KayembaLuwaga/Automated-Multipurpose-Distiller/Project_Pics/multipurpose_distiller_assemblyf.png

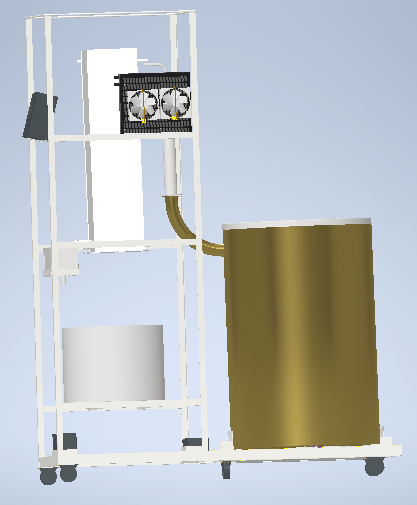
Project_Pics/multipurpose_distiller_assemblyf.png
