KayembaLuwaga/Automated-Multipurpose-Distiller/Project_Pics/multipurpose_distiller_assembly.png

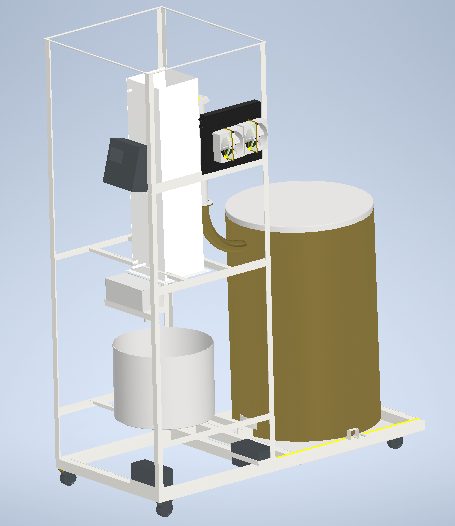
Project_Pics/multipurpose_distiller_assembly.png
