KayembaLuwaga/Automated-Multipurpose-Distiller/README.md

# Automated-Multipurpose-Distiller
Technical design, modeling &amp; optimization, and implementation of a Automated Multipurpose Distiller
