KayembaLuwaga/Automated-Multipurpose-Distiller/MATLAB_hw_programs/variables_attribution.docx

Variables Attribution

Machine Processes
Process | Actuator | Variable
Convection System | Radiator Fan | Atmospheric_Temp
| | Radiator_Temp
Cooling System | Coolant Pump | Referrential_Distillate_Temp
| | Distillate_Temp
| | Condenser_Temp
Distillate Draining System | Solenoid Valve | Distillate_Level
| | Referrential_Distillate_Level
Heater System | AC Heater Element | Still_Temp
| | Referrential_Still_Temp
| | Machine_Run_State
Functions
Function | Variable | Variable’s Values
System Monitor Function | Machine_Run_State | “Standby”, “Running” : (0, 1)
