KayembaLuwaga/Automated-Multipurpose-Distiller/MATLAB_hw_programs/twerk.jpg

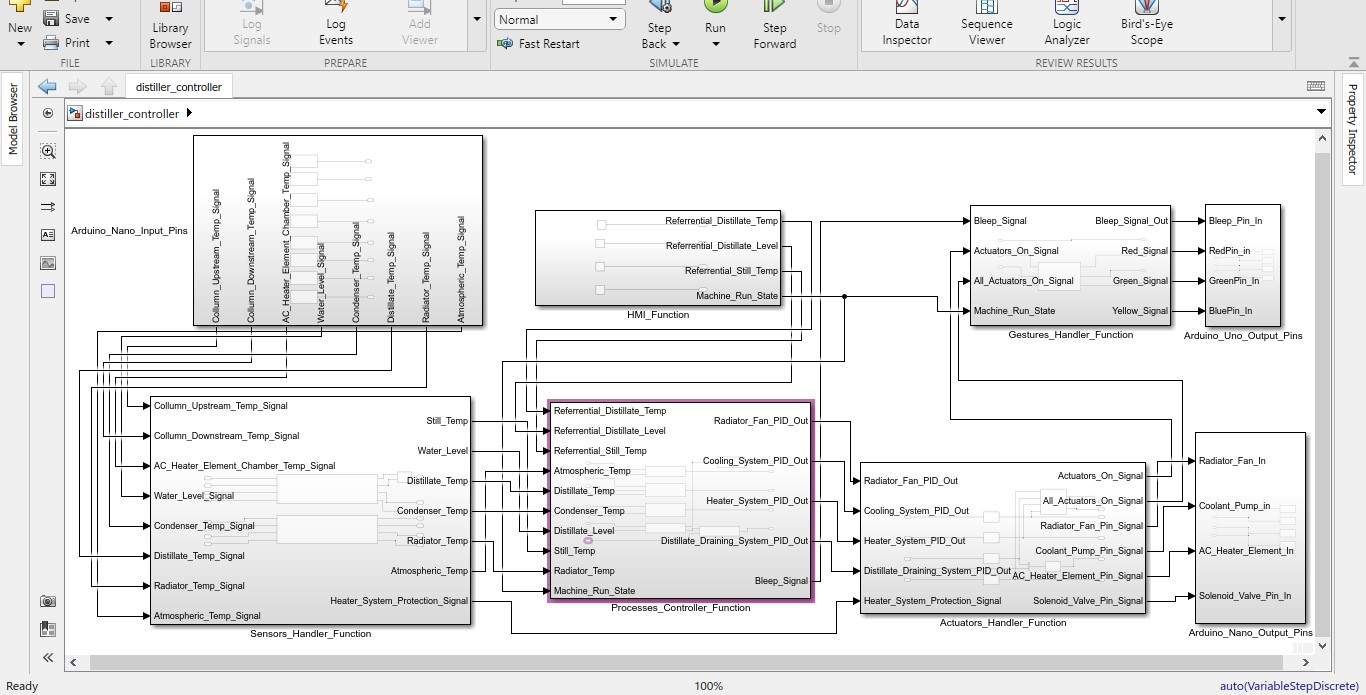
MATLAB_hw_programs/twerk.jpg
