KayembaLuwaga/Automated-Multipurpose-Distiller/Project_Pics/actuators_relay_switch.jpg

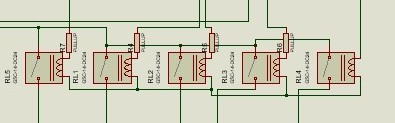
Project_Pics/actuators_relay_switch.jpg
