KayembaLuwaga/Automated-Multipurpose-Distiller/Project_Pics/actutors_hnd_func.jpg

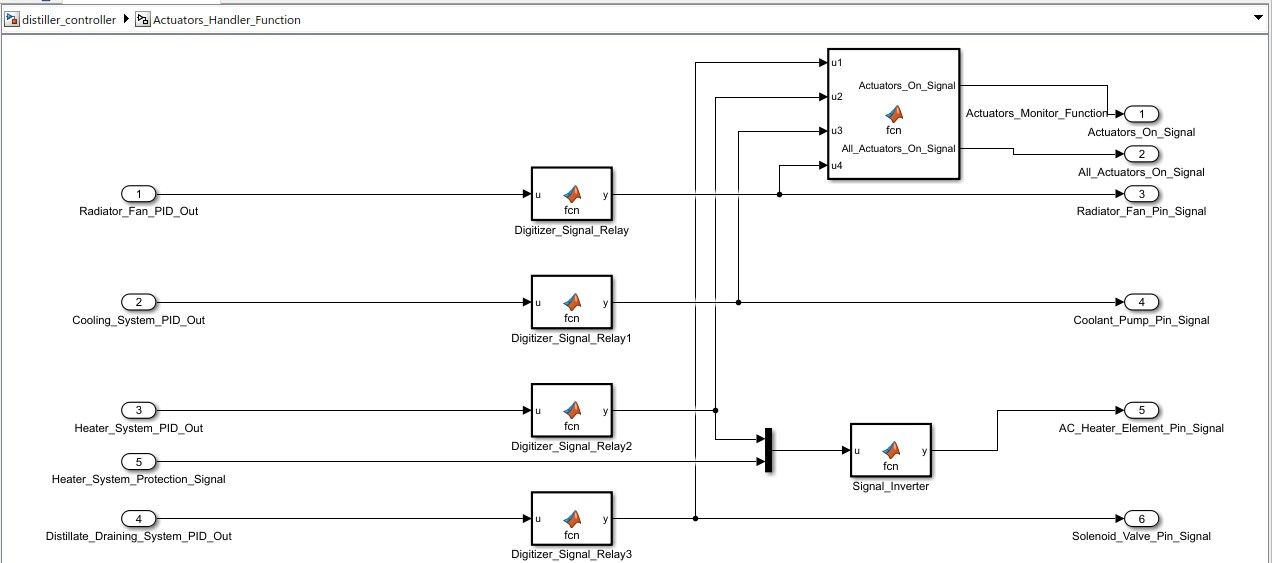
Project_Pics/actutors_hnd_func.jpg
