KayembaLuwaga/Automated-Multipurpose-Distiller/Project_Pics/bode_distillate.jpg

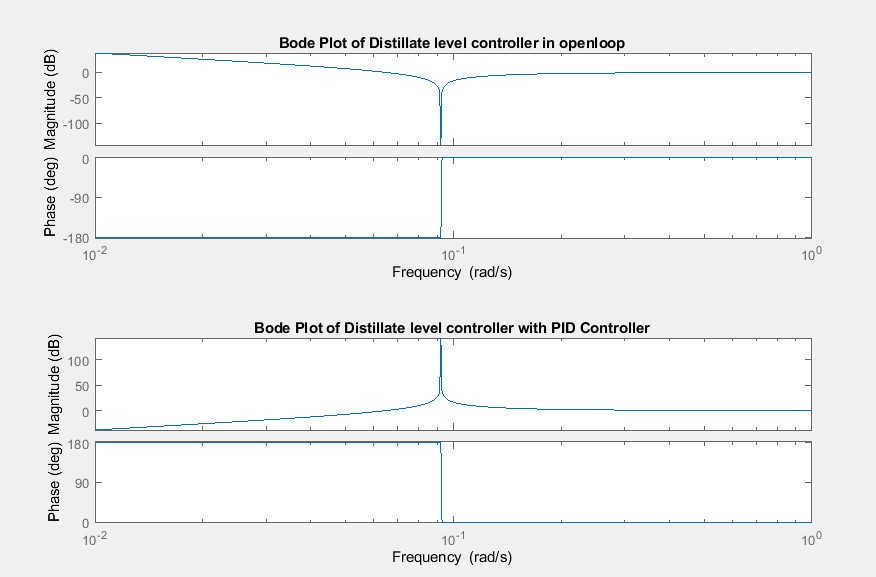
Project_Pics/bode_distillate.jpg
