KayembaLuwaga/Automated-Multipurpose-Distiller/Project_Pics/Copy of disitlate.jpg

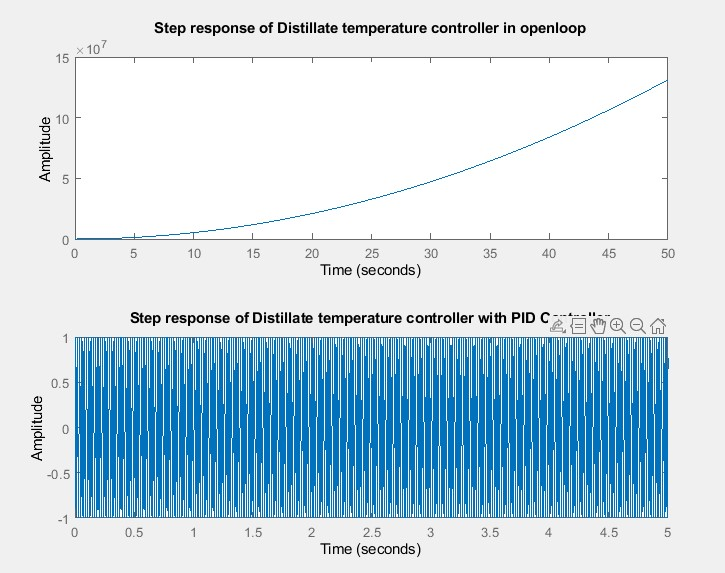
Project_Pics/Copy of disitlate.jpg
