KayembaLuwaga/Automated-Multipurpose-Distiller/Project_Pics/frame_displacement.JPG

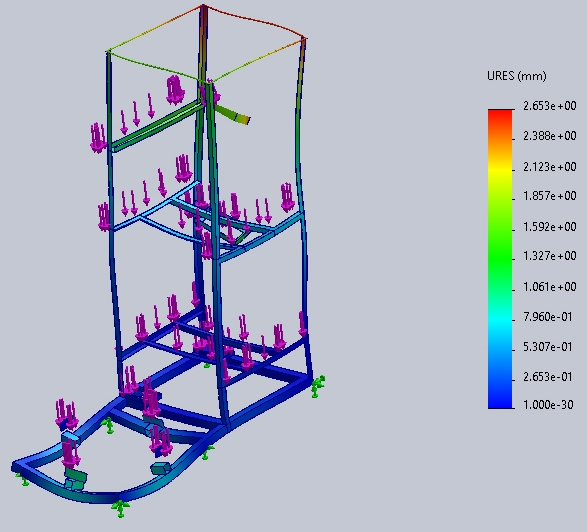
Project_Pics/frame_displacement.JPG
