KayembaLuwaga/Automated-Multipurpose-Distiller/Project_Pics/frame_von_Misses_stress.JPG

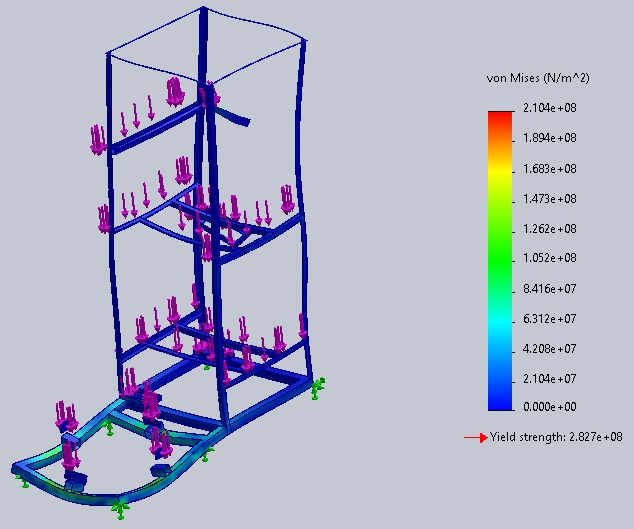
Project_Pics/frame_von_Misses_stress.JPG
