KayembaLuwaga/Automated-Multipurpose-Distiller/Project_Pics/gestures+func.jpg

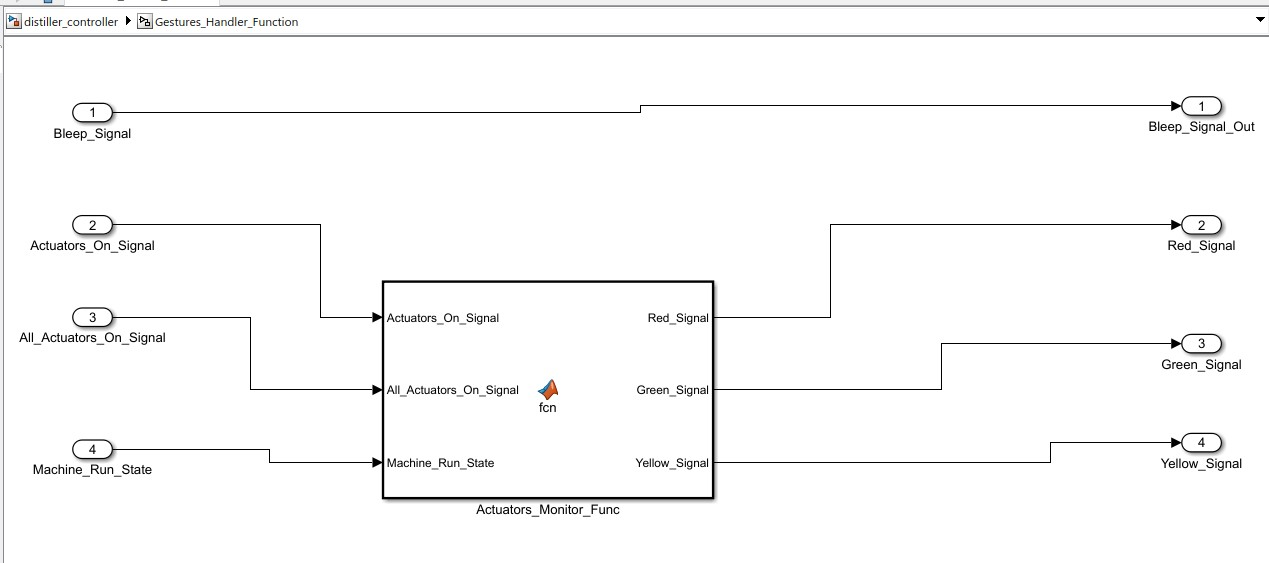
Project_Pics/gestures+func.jpg
