KayembaLuwaga/Automated-Multipurpose-Distiller/Project_Pics/hdw_ctrl_circuit.jpg

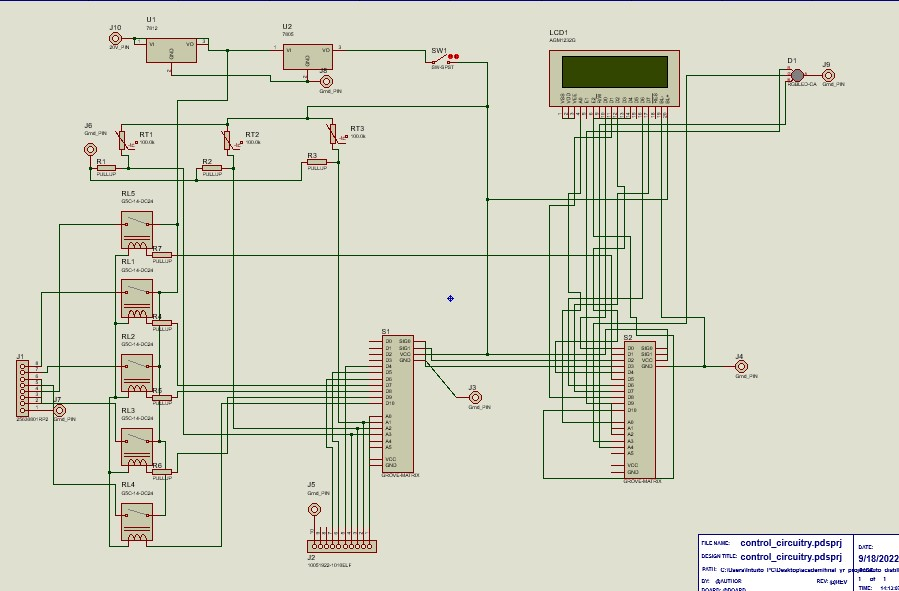
Project_Pics/hdw_ctrl_circuit.jpg
