KayembaLuwaga/Automated-Multipurpose-Distiller/Project_Pics/heat conv.jpg

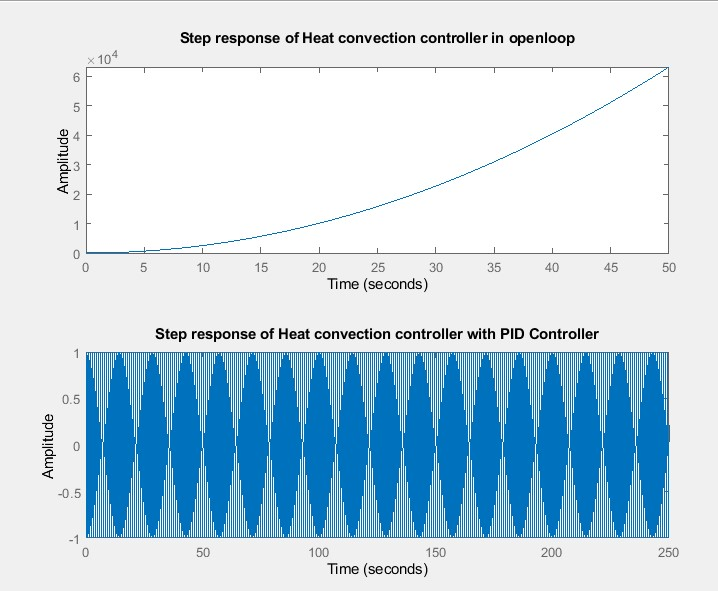
Project_Pics/heat conv.jpg
