KayembaLuwaga/Automated-Multipurpose-Distiller/Project_Pics/HMI_Function.jpg

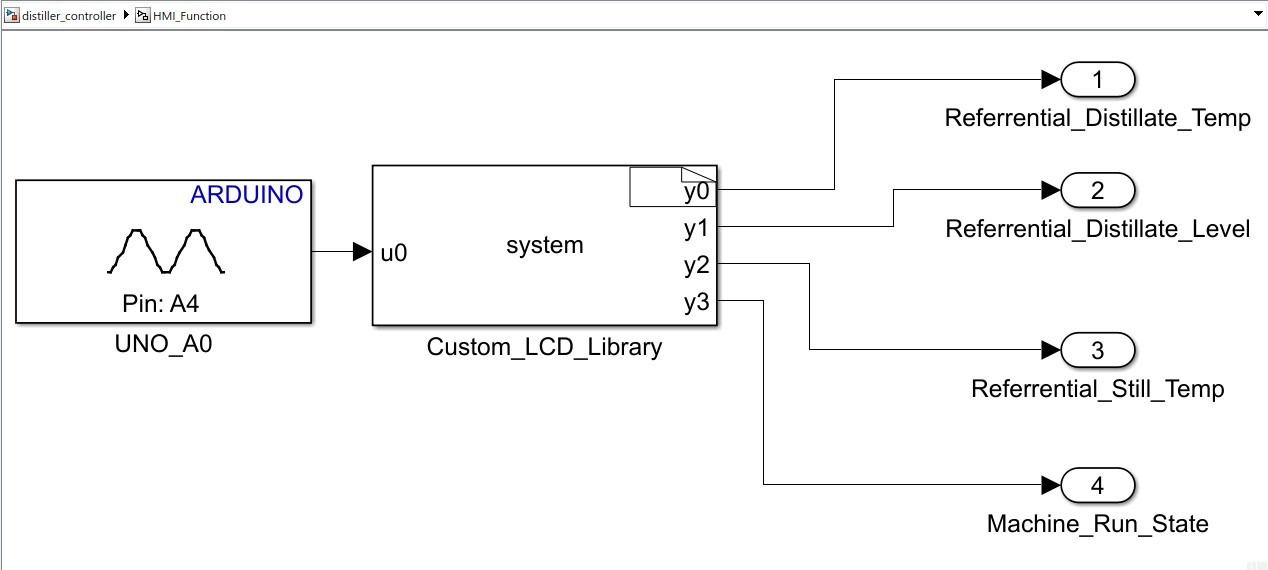
Project_Pics/HMI_Function.jpg
