KayembaLuwaga/Automated-Multipurpose-Distiller/Project_Pics/holistic_cntrlr.jpg

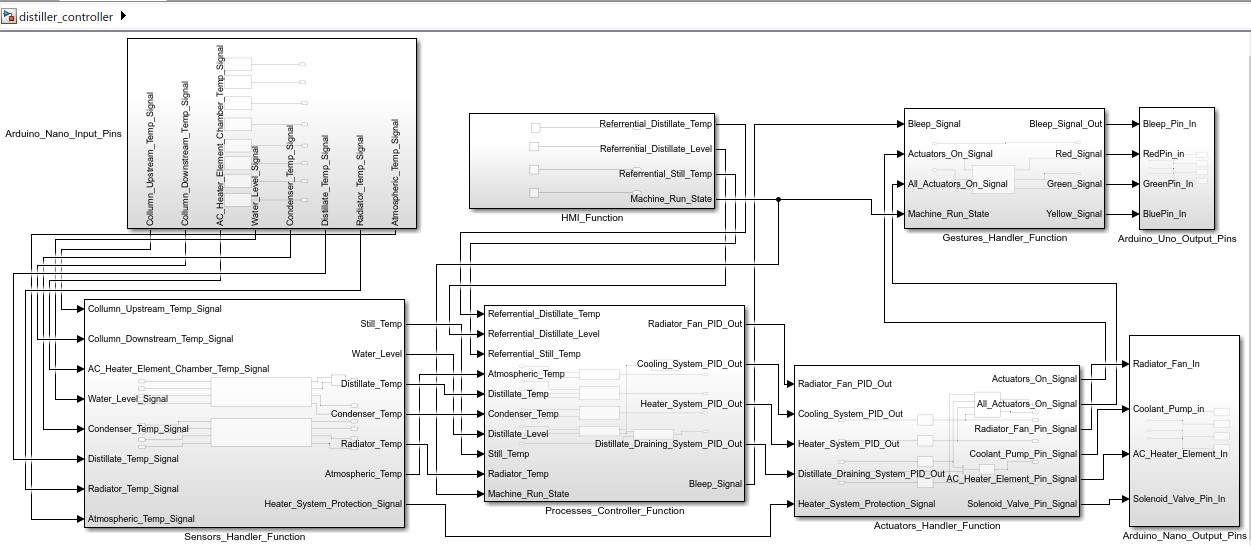
Project_Pics/holistic_cntrlr.jpg
