KayembaLuwaga/Automated-Multipurpose-Distiller/Project_Pics/IMG_20210805_101857.jpg

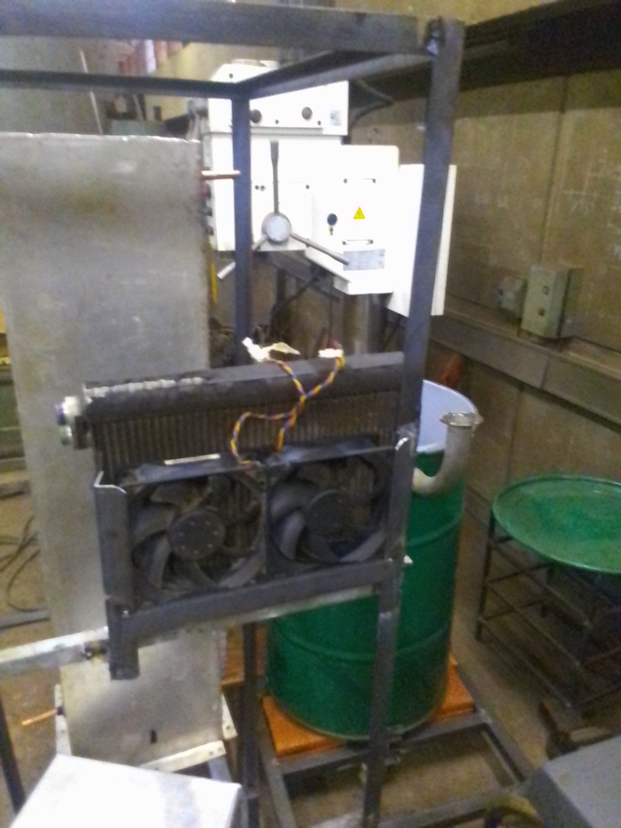
Project_Pics/IMG_20210805_101857.jpg
