KayembaLuwaga/Automated-Multipurpose-Distiller/Project_Pics/IMG_20220809_165540.jpg

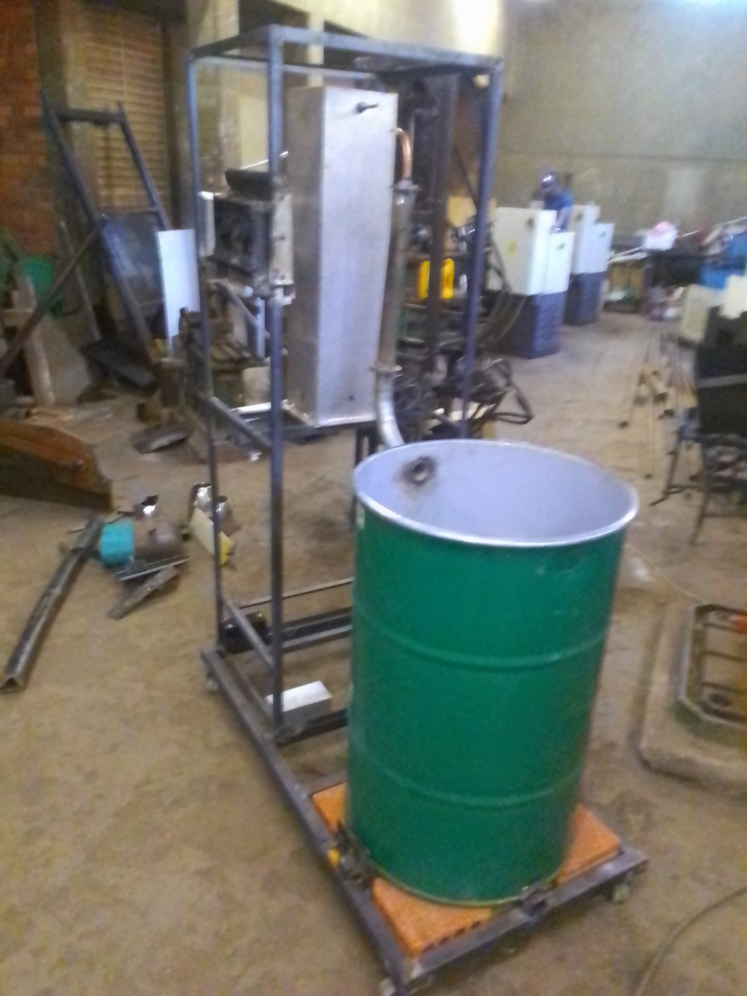
Project_Pics/IMG_20220809_165540.jpg
