KayembaLuwaga/Automated-Multipurpose-Distiller/Project_Pics/IMG_20220809_165649.jpg

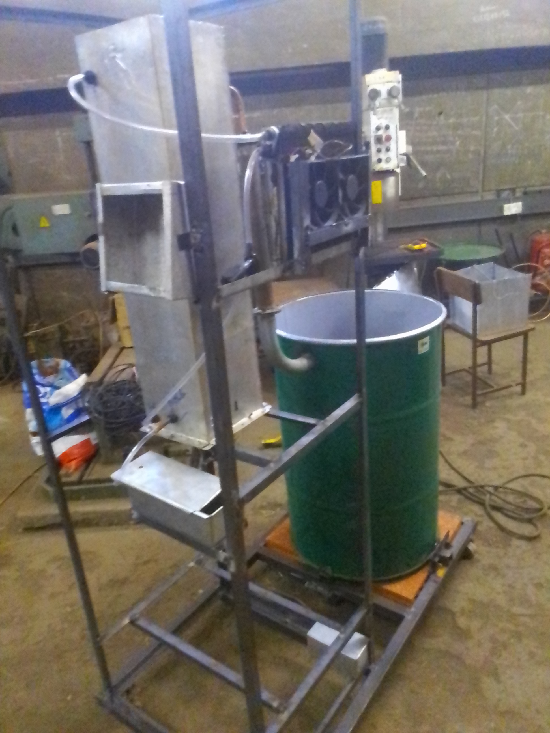
Project_Pics/IMG_20220809_165649.jpg
