KayembaLuwaga/Automated-Multipurpose-Distiller/Project_Pics/IMG_20220809_171638_HDR.jpg

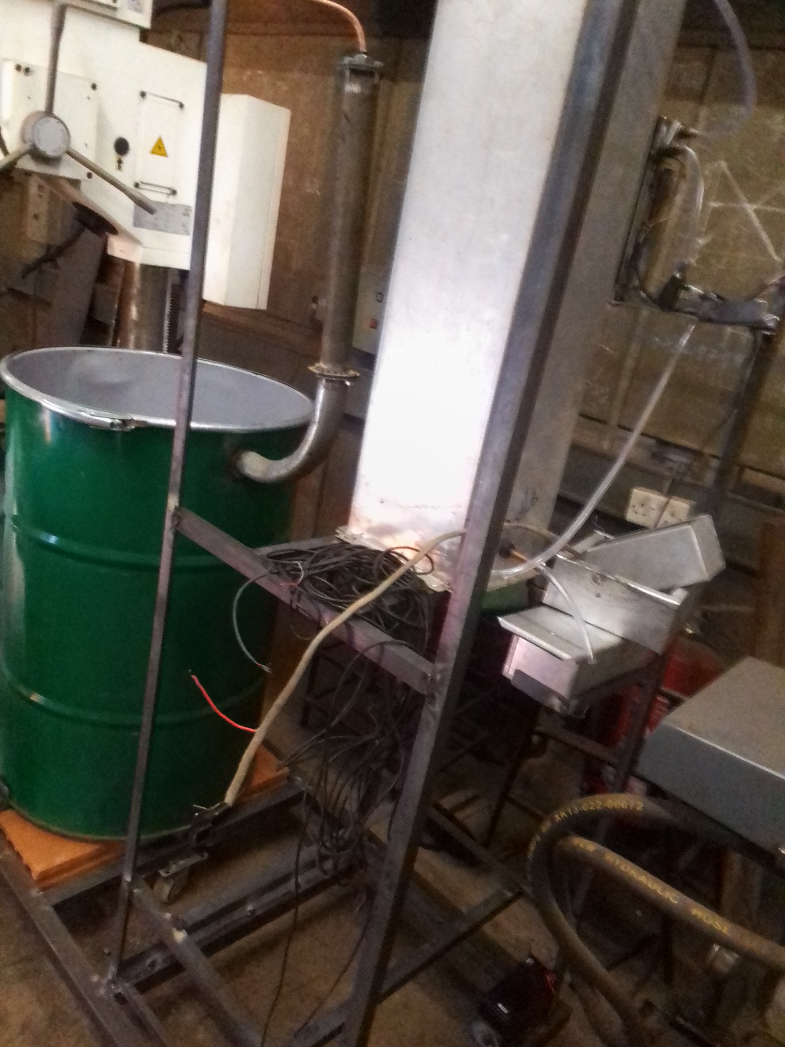
Project_Pics/IMG_20220809_171638_HDR.jpg
