KayembaLuwaga/Automated-Multipurpose-Distiller/Project_Pics/level.jpg

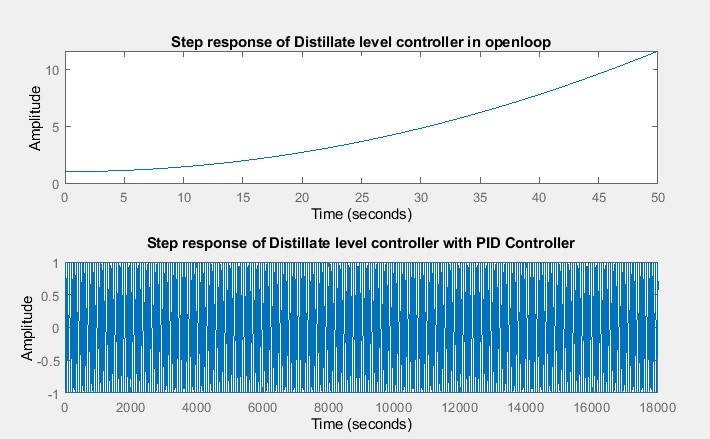
Project_Pics/level.jpg
