KayembaLuwaga/Automated-Multipurpose-Distiller/Project_Pics/processes_Ctrlr_fnc.jpg

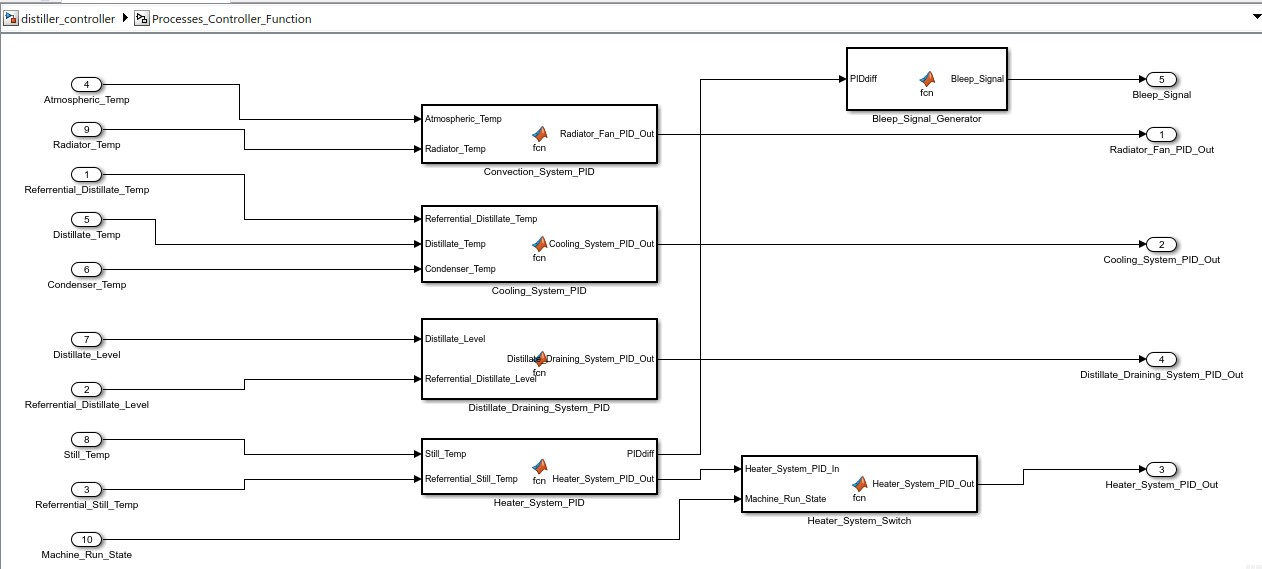
Project_Pics/processes_Ctrlr_fnc.jpg
