KayembaLuwaga/Automated-Multipurpose-Distiller/Project_Pics/sensors_handler_function.jpg

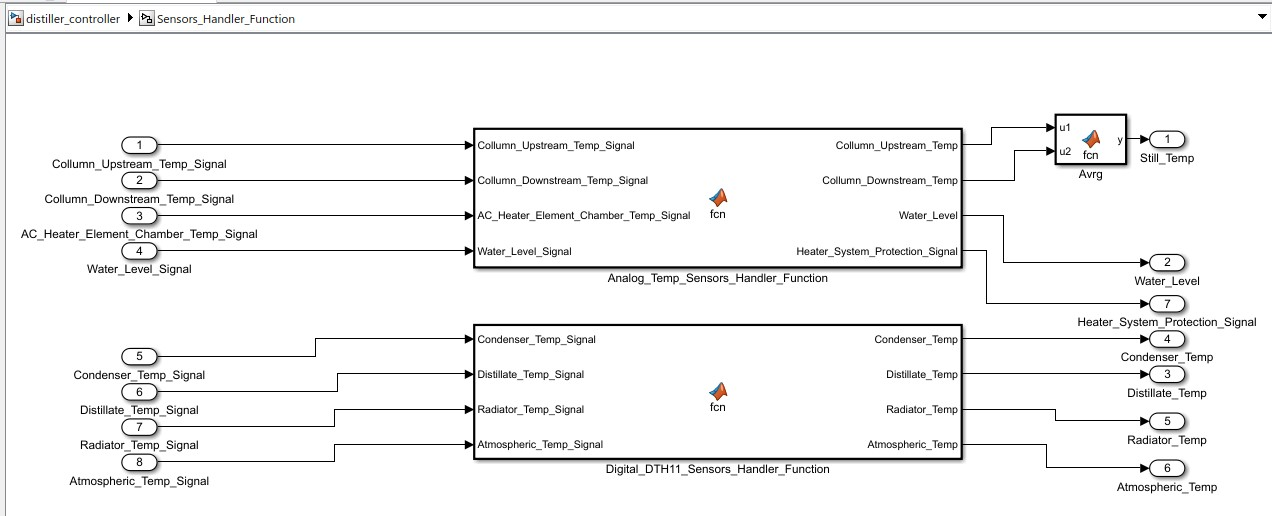
Project_Pics/sensors_handler_function.jpg
