KayembaLuwaga/Automated-Multipurpose-Distiller/Project_Pics/still_displacement.JPG

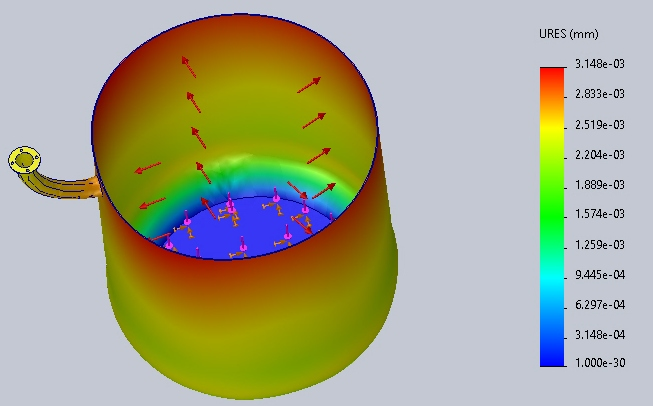
Project_Pics/still_displacement.JPG
