KayembaLuwaga/Automated-Multipurpose-Distiller/Project_Pics/still_thermo.JPG

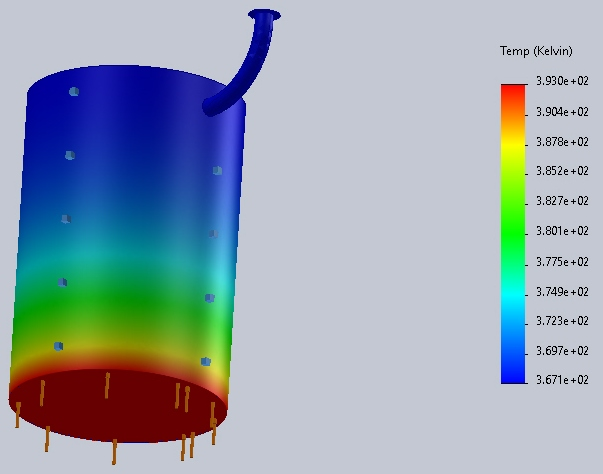
Project_Pics/still_thermo.JPG
