KayembaLuwaga/Automated-Multipurpose-Distiller/(list of files, cad)

Other CAD files:
CAD_Autodesk_Inventor/AC_heater_coil.ipt
CAD_Autodesk_Inventor/AC_power_box.ipt
CAD_Autodesk_Inventor/boiler_plates.ipt
CAD_Autodesk_Inventor/bottom_mesh.ipt
CAD_Autodesk_Inventor/condenser.ipt
CAD_Autodesk_Inventor/control_panel_box.ipt
CAD_Autodesk_Inventor/distilate_tank.ipt
CAD_Autodesk_Inventor/fractionating_column.ipt
CAD_Autodesk_Inventor/fractionating_column_cover.ipt
CAD_Autodesk_Inventor/multipurpose_distiller_assembly.iam
CAD_Autodesk_Inventor/multipurpose_distiller_assembly.idw
CAD_Autodesk_Inventor/oil_water_separator.ipt
CAD_Autodesk_Inventor/radiator.ipt
CAD_Autodesk_Inventor/radiator_fan.ipt
CAD_Autodesk_Inventor/refractory_quarry_tile.ipt
CAD_Autodesk_Inventor/refractory_quarry_tile_pad.ipt
CAD_Autodesk_Inventor/roller_coaster_wheel.ipt
CAD_Autodesk_Inventor/solar_power_buffer_battery.ipt
CAD_Autodesk_Inventor/still.ipt
CAD_Autodesk_Inventor/still_cover.ipt
CAD_Autodesk_Inventor/still_system.iam
