KayembaLuwaga/Automated-Multipurpose-Distiller/report/31_friday_Project_Presentation_Kayemba_Augustine_1800725469_Design_and_Construction_of_an_Automated_Multipurpose_Distiller (2).pdf

# MEC4204 Final Year Project

# Design and Construction of an Automated Multipurpose Distiller

# Supervised by: Mr. Gerald KISEKKA Co-Supervised by: Mr. Joseph NDEMERE ARINEITWE

Presented by: | KAYEMBA Augustine
Student No: | 1800725469

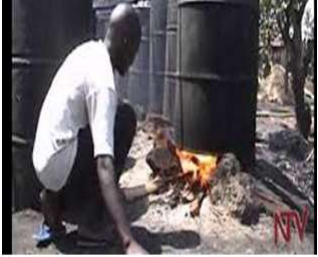
[picture p24: figure]

# Introduction

# - Steam distillation is the widely used method for the extraction of essential oil - Currently, only few industries produce bioethanol fuel largely because of the cost of importing a sophisticated distiller

# Problem Statement

# The seasonal fluctuating markets of both ethanol and essential oil demands

# Current small scale steam distillation technologies are very laborious, have very high startup costs

# Main Objective

# To design and construct a cost-effective multipurpose automated distiller technology of essential oils and ethanol

# Specific Objectives

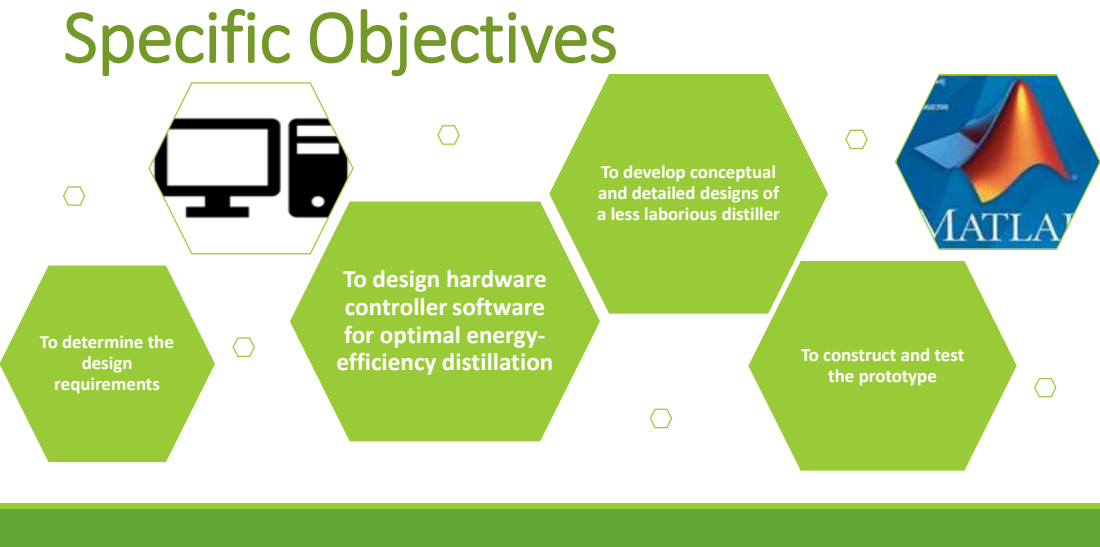
[picture p25: page 5]

To develop conceptual
and detailed designs of
a less laborious distiller

To design hardware
controller software
for optimal energy-
efficiency distillation

To determine the
design
requirements

To construct and test
the prototype

Design, analysis,
validation

Hardware
controller software

Optimal automation
and hybridization

# Scope

Construction of
the feasibility
incremental prototype

# Justification

# The inflexibility of the current small scale steam distillation technologies with the nature of the distillation process Current small scale steam distillation technologies are very energy-inefficient, laborious and have very high startup costs

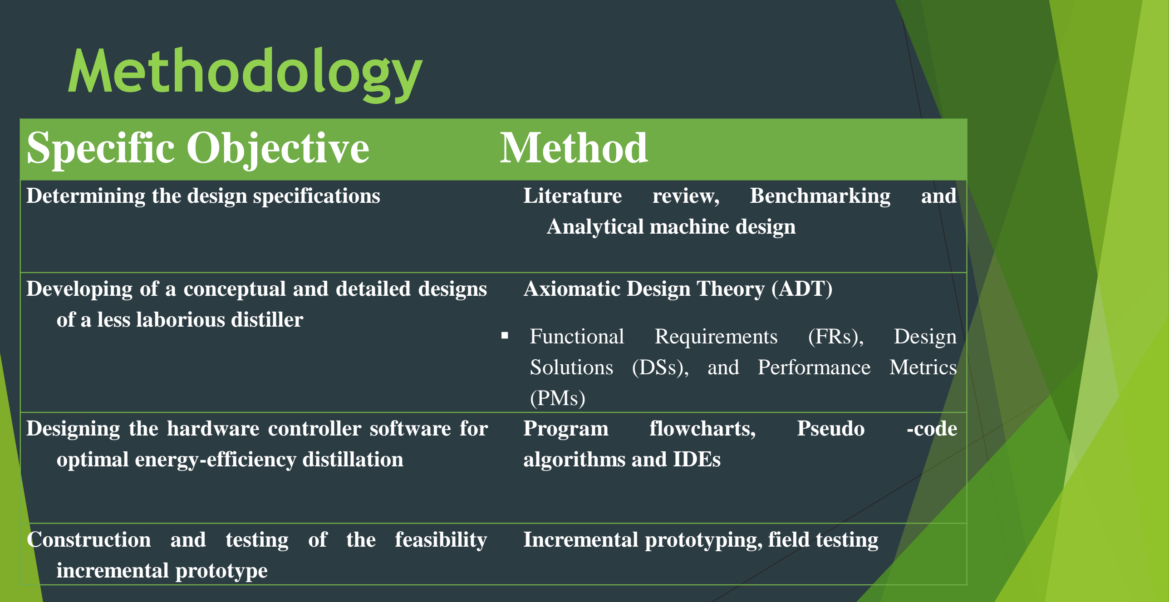
[picture p26: figure]
Methodology; Specific Objective; Method; Determining the design specifications; Literature; review,; Benchmarking; and; Analytical machine design; of a less laborious distiller; Axiomatic Design Theory (ADT); Functional; Requirements; (FRs),; Design; Solutions (DSs), and Performance Metrics; (PMs); optimal energy-efficiency distillation; Program; flowcharts,; Pseudo; -code; algorithms and IDEs; incremental prototype; Incremental prototyping, field testing

Developing of a conceptual and detailed designs

Designing the hardware controller software for

Construction and testing of the feasibility

# Limitations

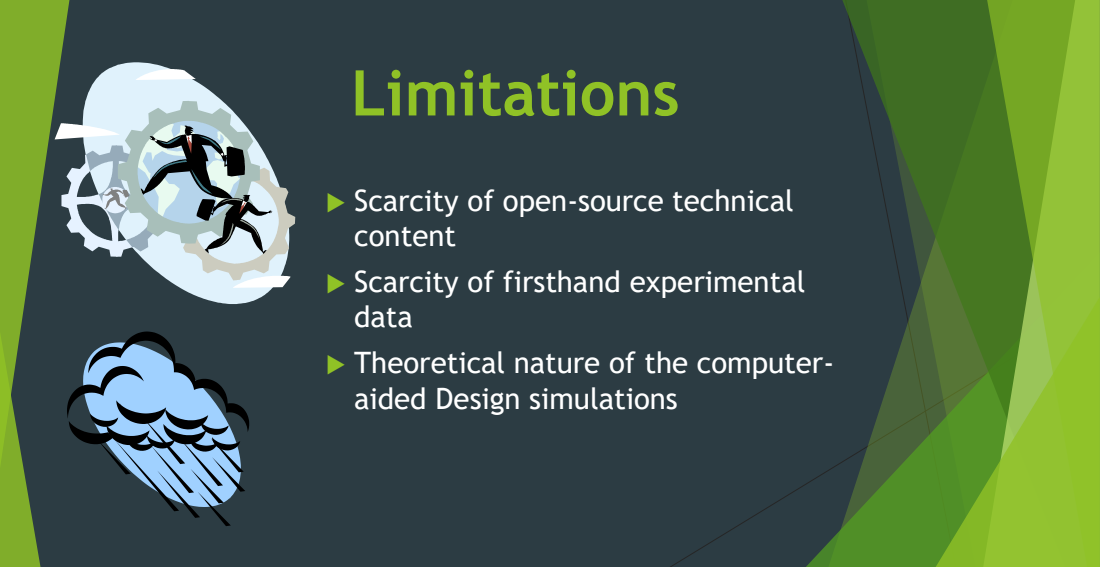
[picture p27: page 9]

Scarcity of open-source technical
content
Scarcity of firsthand experimental
data
Theoretical nature of the computer-
aided Design simulations

# Product Specifications

Part | Parameter | Designed Value | Marginal Value
Still | Threshold still volume | 200Ltrs | 226Ltrs
Condenser | Distillate Temperature | 30⁰C | 27⁰C
Heater primer | Distillate yield loss | 1g/s | 1.1g/s
Holistic Device | Cost Price | UGX 3,000,000 | UGX 1,500,000
Process controller | Maximum | controller | loop
overshoot error
10% | 5%
Process vessel | Energy | efficiency | rate | per
distillate volume
7.2kJ/Ltr | 6kJ/Ltr

# Product Design | Hardware Design

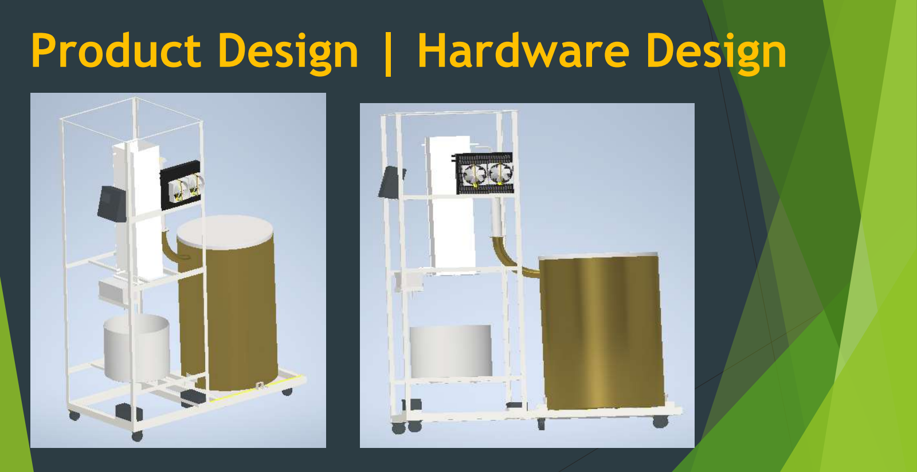
[picture p28: page 11]

# Product Design | Hardware Design Validation

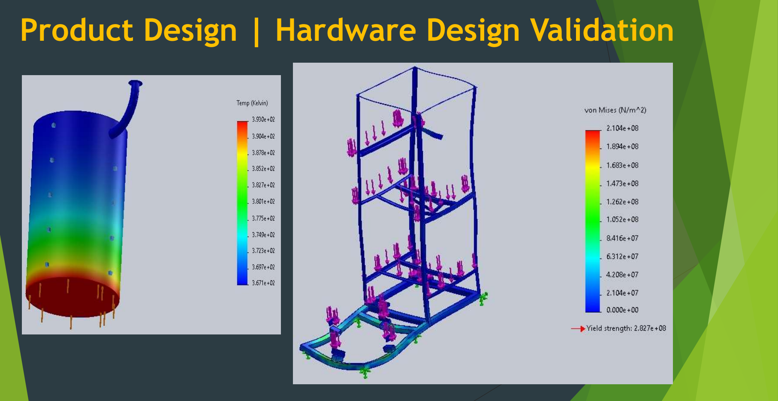
[picture p29: page 12]

## Product Design | Hardware Controller Circuitry Design

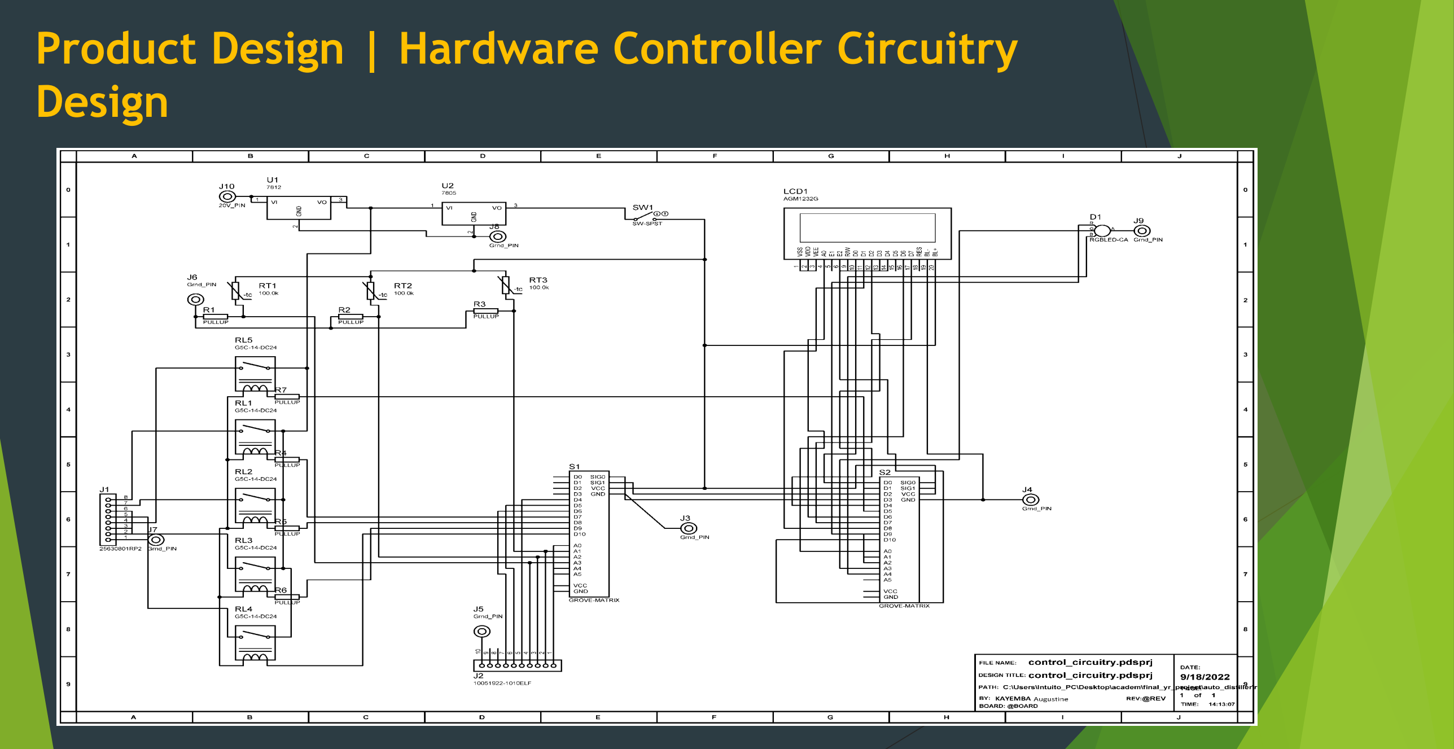
[picture p30: page 13]

# Product Design | Hardware Controller Software Design

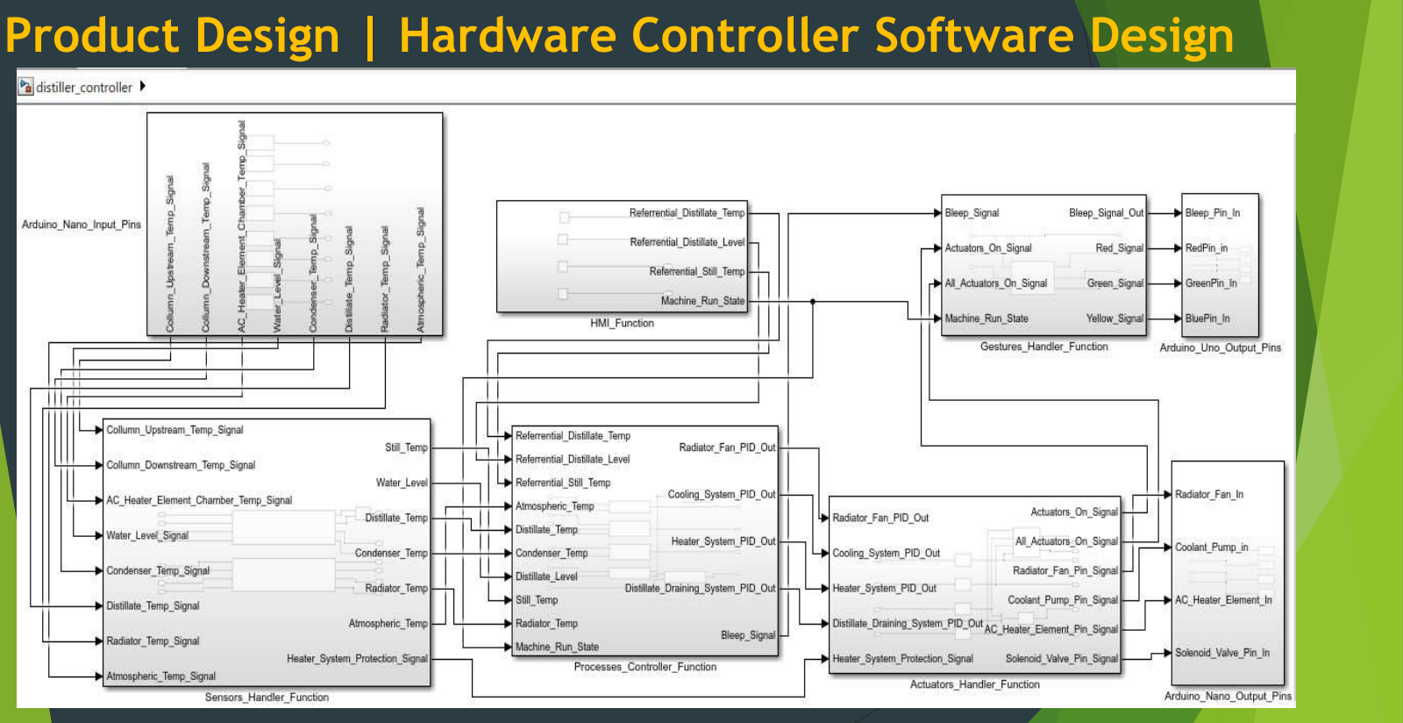
[picture p31: page 14]

# Product Design | Hardware Controller Software Design Validation

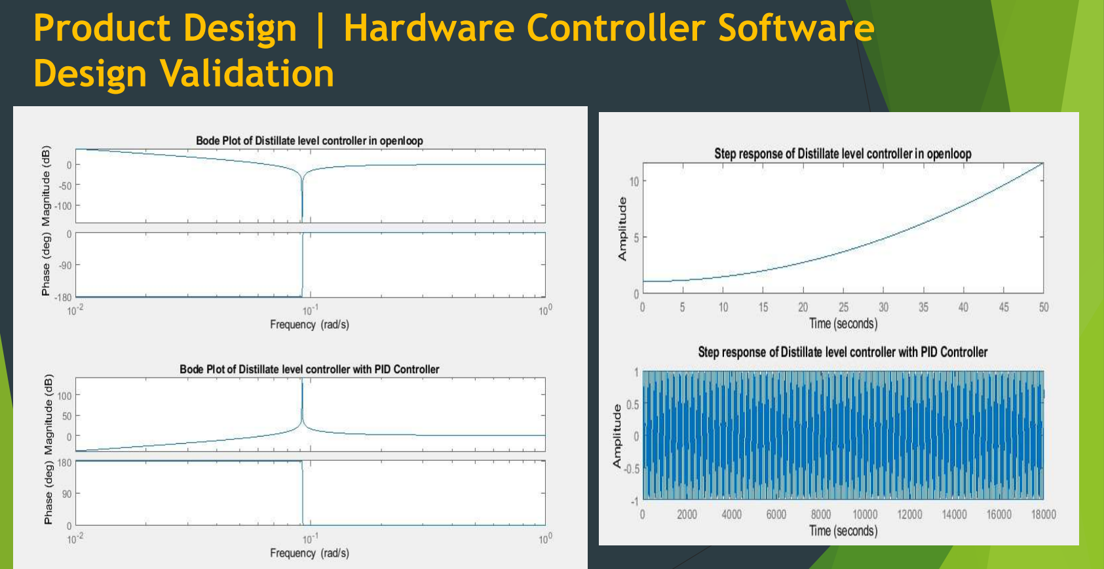
[picture p32: page 15]

# Results

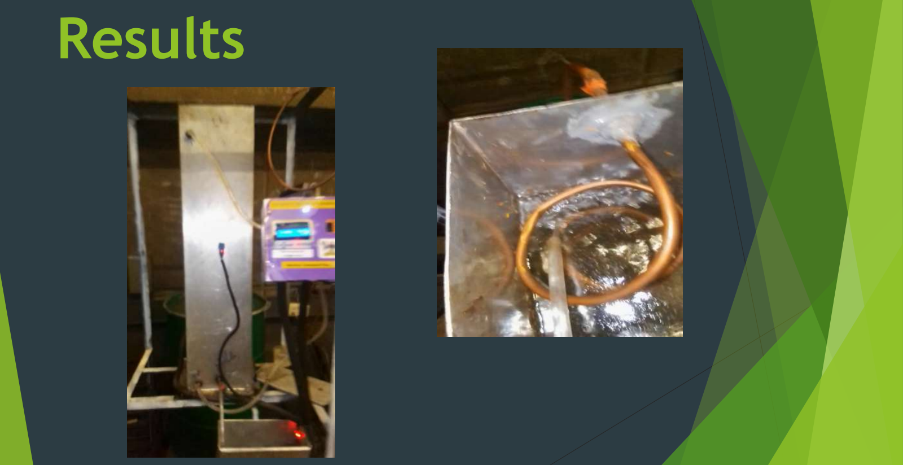
[picture p33: page 16]

# Results | Implementation Timeline

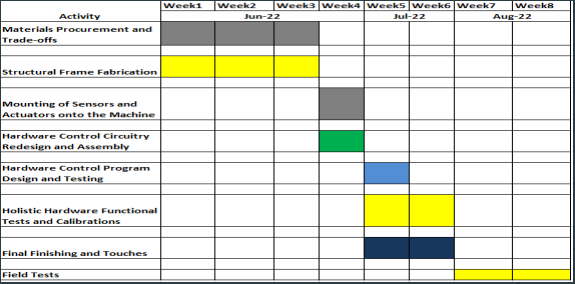
[picture p34: figure]

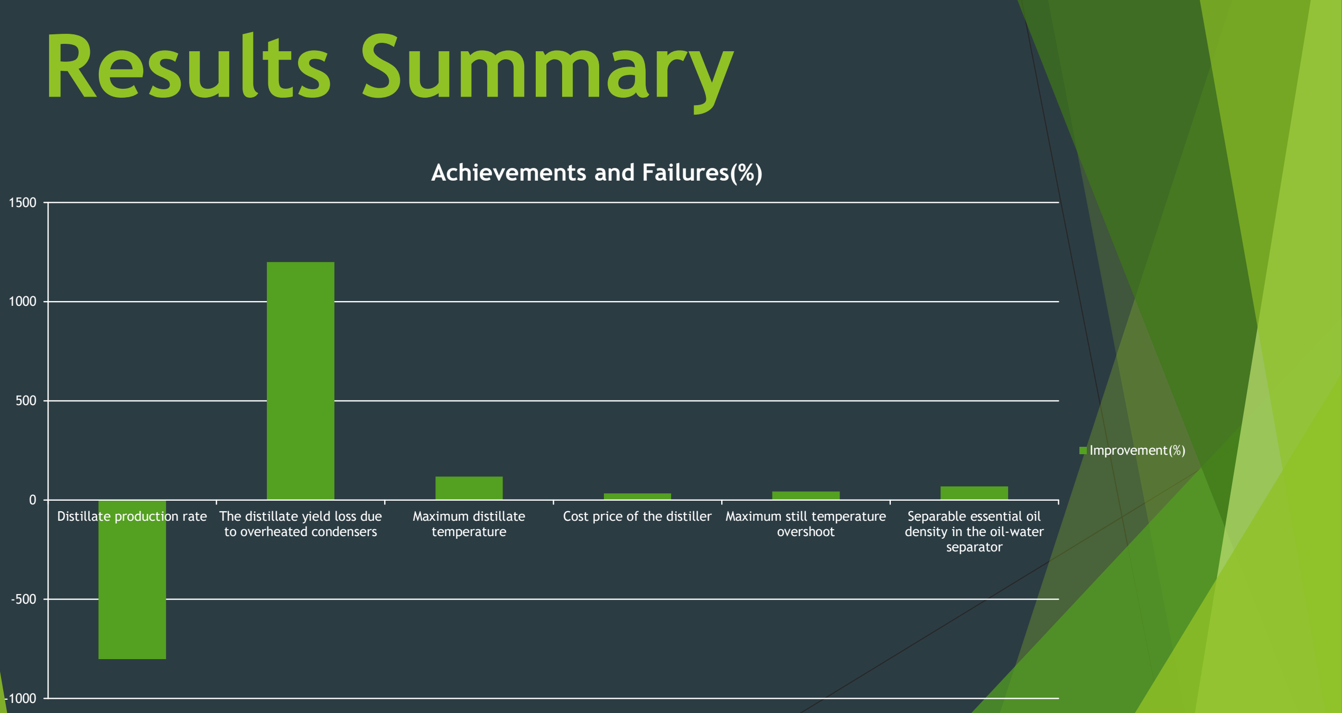
[picture p35: figure]
Results Summary; to overheated condensers; Maximum distillate temperature; overshoot; Separable essential oil density in the oil-water separator; Achievements and Failures(%); Improvement(%)

Distillate production rate The distillate yield loss due

Cost price of the distiller Maximum still temperature

# Results Summary

## - 800% reduction from the benchmarked distillate production rate - 118% reduction in the maximum distillate temperature - 1200% reduction in the distillate yield loss - 33.3% reduction in the cost price

# Thank You

Q & A
