KayembaLuwaga/Automated-Multipurpose-Distiller/Project_Pics/nano_board_calibration_code.PNG

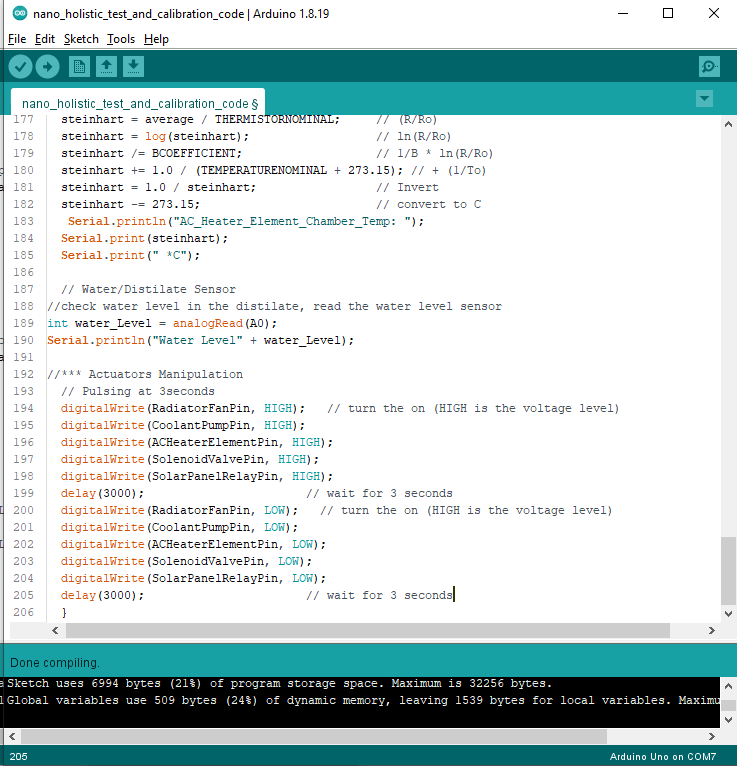
Project_Pics/nano_board_calibration_code.PNG
