KayembaLuwaga/Automated-Multipurpose-Distiller/Project_Pics/PID_controllers_design_validation.jpg

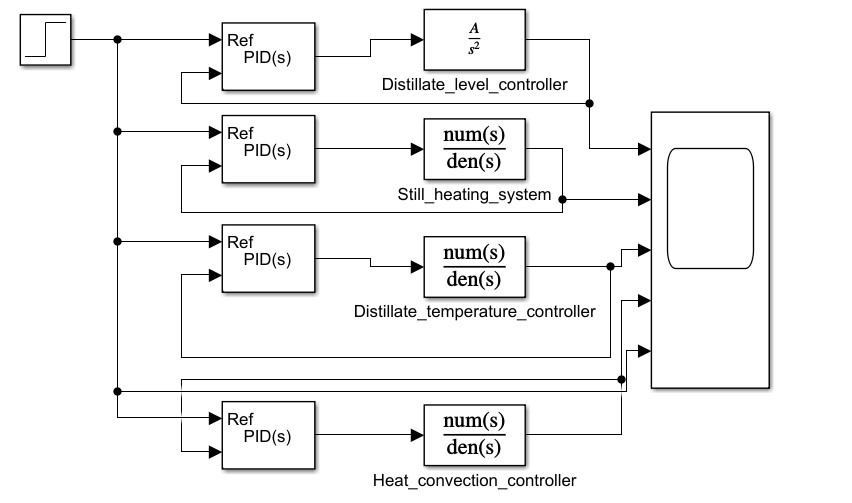
Project_Pics/PID_controllers_design_validation.jpg
